NotRyanTM/Cuddly-Engine-AKA-ble-battery-telemetry/(commit log)

2026-10-25 Add fake board stage 1: print fake readings
2026-10-25 Add pack function and fake board stage 2: print 11-byte messages
2026-10-25 Fake board stage 3: serve messages over TCP on port 5050
2026-10-25 Fake board stage 3 and 4: TCP server and test client
2026-10-25 Fake board: skip sequence numbers; rename test client so pytest ignores it
    The fake board now skips about 1 sequence number in 50 so the app's
    lost-message counter has something to detect. test_client.py was being
    collected by pytest and failing without a running board, so it is now
    watch_board.py, and both scripts only start under __main__.
2026-10-25 Create Android project and ignore build files
    Empty Compose app (com.example.batterytelemetry) at the repository root.
    Adds Android and Gradle entries to .gitignore so build output and
    local.properties stay out of the repository.
2026-10-25 Add Kotlin PacketParser with unit tests
    Decodes the 11-byte telemetry message from docs/protocol.md into a
    Reading, matching bridge/protocol.py: rejects wrong lengths and
    unsupported versions, and masks the unsigned fields. Tests cover the
    worked example, negative current, the largest unsigned values, wrong
    length, wrong version and computed power.
2026-10-25 Add TelemetrySource.kt (missed from the previous commit, which held the Stage 0 libraries)
2026-10-25 Fill in FakeTelemetrySource and its tests
    FakeTelemetrySource now emits a draining battery every 200 ms, wraps the
    sequence number after 65535 and occasionally skips one to fake a lost message.
    Tests cover falling voltage, current range and the sequence wrap.
2026-10-25 Add telemetry screen with live power chart and UI tests
    TelemetryScreen shows connection status, voltage, current, power, lost
    messages and a power chart drawn on a Compose Canvas. TelemetryRoute wires
    it to the ViewModel fed by FakeTelemetrySource, replacing the template
    greeting in MainActivity.
    Compose UI tests check the displayed values and the waiting state. Espresso
    is upgraded to 3.7.0 (and androidx.test.ext junit to 1.3.0) because 3.5.1
    calls InputManager.getInstance, which Android API 37 no longer has.
2026-10-25 Add NetworkTelemetrySource to read the fake board over TCP
    NetworkTelemetrySource connects to 10.0.2.2:5050 (the laptop, from inside the
    emulator), reads exact 11-byte messages with readFully, and retries every
    2 seconds when the connection is refused or drops. It closes its socket and
    reports DISCONNECTED when nothing is collecting anymore. The app now uses it
    by default; createTelemetrySource() is the one place to switch sources.
    Android 17 (API 37) blocks local-network connections unless the app holds
    ACCESS_LOCAL_NETWORK, so the manifest declares it and MainActivity asks for it
    at startup.
    Tests run a local TCP server: the worked example, a message split across two
    packets, reconnectin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
2026-10-27 Fake board accepts sample-interval config
2026-10-27 Fake board accepts sample-interval config; watcher can send it
2026-10-27 Fix race that could leave the socket open after cancelling
2026-10-27 TelemetrySource can set a sample interval
2026-10-27 NetworkTelemetrySource sends the sample interval over TCP
2026-10-27 Fast/Normal/Slow buttons change the board's sample rate
2026-10-28 BLE bridge: forward board readings to the app and config back to the board
2026-10-28 Show the measured sample rate
2026-10-28 ESP32 firmware stage 1: fake readings over BLE, accepts interval config
2026-10-29 Firmware stage 2: real ACS711 current and divider voltage
    Reads the ACS711 on GPIO34 and the 20k/10k divider on GPIO35, averages
    16 samples per reading, and prints readings over serial when no client
    is connected. sketch.yaml pins the board to ESP32 Dev Module. README
    updated for the ACS711 hardware and first bench check.
2026-11-06 Firmware: discard ADC samples after switching pins
    The sampling capacitor still holds the last pin's voltage, and the divider is too high-impedance to recharge it in one sample. Also set one ADC range for all pins.
    [battery_telemetry.ino]
2026-11-06 Don't count a board restart as lost messages
    The board's clock running backward means it restarted. Add no lost messages for that jump and clear the chart, since old readings don't fit the new clock.
2026-11-06 README: describe the real board setup and current results
2026-11-11 Docs: hardware write-up with photos and schematic
    Adds docs/hardware.md: parts, schematic, connections, how the firmware
    converts readings, design numbers (divider range, current resolution,
    zero-point error), a bring-up checklist, troubleshooting and the first
    bench results. Adds photos of the breadboard and bench supply. The
    README's Hardware section now summarizes and links to it.
